SorianoJuan/chacaico-automation/firmware/nodes/node_2/README.md

# Nodo 2

Firmware **0.5.0**, ID LoRa **2**, placa objetivo **HTCC-AB01 / ASR6501**.
La revisión impresa de esta PCB debe verificarse por separado; no se infiere de la del nodo 1.

- `node_2.ino`: entrada Arduino; rechaza una configuración de otro ID.
- `profile.json`: identidad pública, perfil de compilación y versión.
- `node_config.h`: encabezado **privado e ignorado**, generado desde `.secrets/node-2.json`.
- `build/`: compilación de este nodo, **ignorada** porque el binario incorpora su clave.
- `evidence/`: resultado histórico público de la prueba USB/LoRa.

La lógica está en `../../libraries/ChacaicoNode/src/ChacaicoNode.h` y se comparte
con los otros nodos. Cada nodo mantiene su propia clave y compilación. GPIO2 abre,
GPIO1 cierra, ambos con pulso configurable (50 ms predeterminado); el LED de prueba
conserva su estado tras los destellos. Reposo y pulso se configuran desde la pestaña
Configuración LoRa y se conservan en flash. OTA de firmware no implementado.
Máximo configurable **3000 ms**, pulso aplicado **50 ms**. Requiere bridge0.4.3.
Usar pulsos largos solo con el CubeCell separado de la PCB y la válvula.

Ver [operación y límites](../../../docs/node-configuration.md).

Desde la raíz del repo:

```sh
python3 firmware/build-node.py --id 2
sh firmware/flash-node.sh --id 2 /dev/serial/by-path/PUERTO_FISICO-port0
```

Antes de cargar, identificar físicamente la placa y conectar su antena. Los
CP2102 comparten serial0001: el puerto USB no determina el ID LoRa. La carga USB
reinicia el nodo; no se ejecuta como parte de pruebas offline.

0.5.0 agrega potencia TX, ventanas configurables, señal de bajada y prueba/commit
de potencia. Migra flash anterior; no volver a firmware0.4.x después de migrar.
