SorianoJuan/chacaico-automation/docs/evidence/2026-10-20/both-pulse-limit/home-assistant-confirmed.png

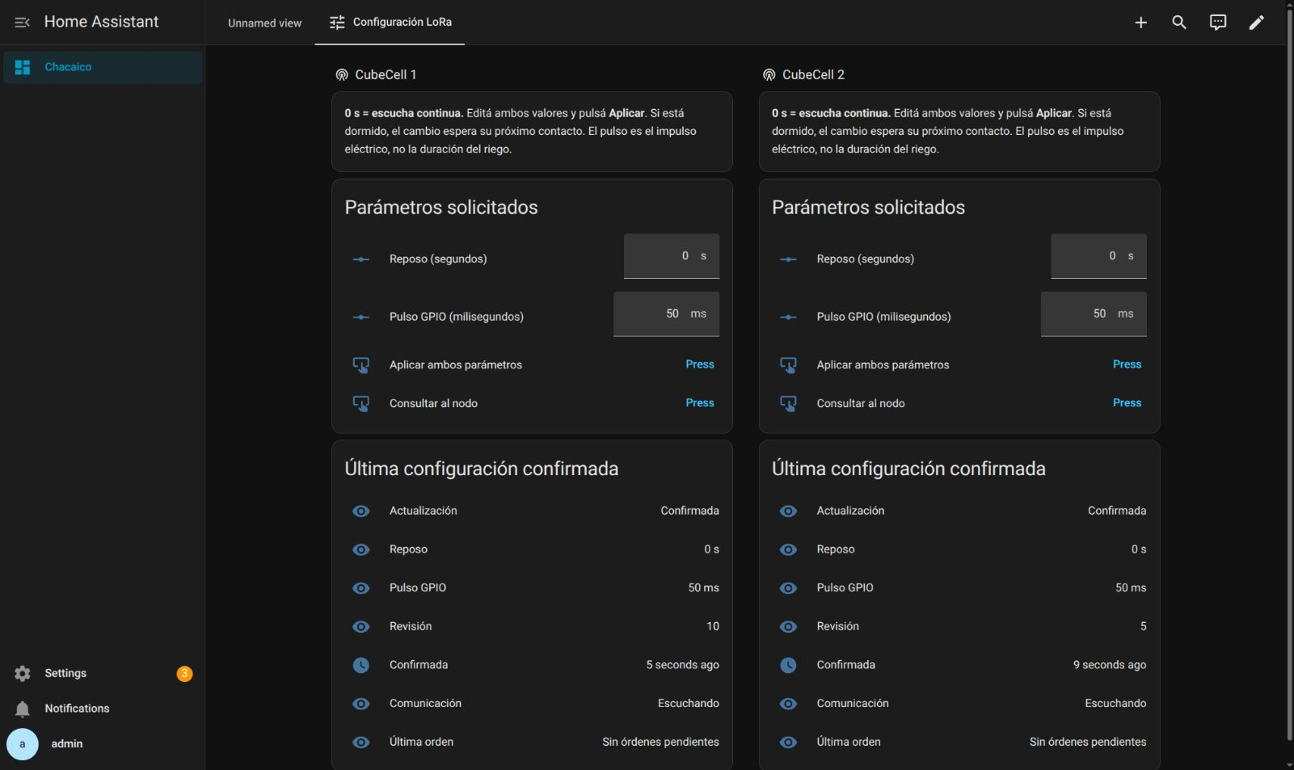
docs/evidence/2026-10-20/both-pulse-limit/home-assistant-confirmed.png
