SorianoJuan/chacaico-automation/docs/evidence/2026-10-22/radio-configuration-stage1/configuracion-lora.png

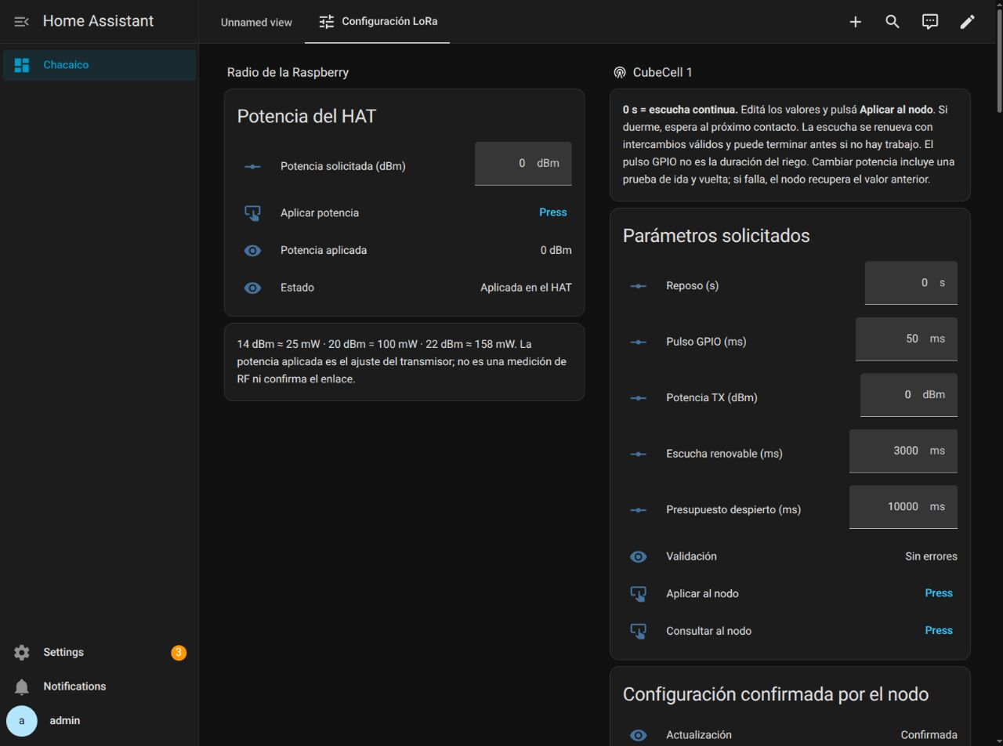
docs/evidence/2026-10-22/radio-configuration-stage1/configuracion-lora.png
