SorianoJuan/chacaico-automation/docs/hardware/adaptacion-aop605-9v.png

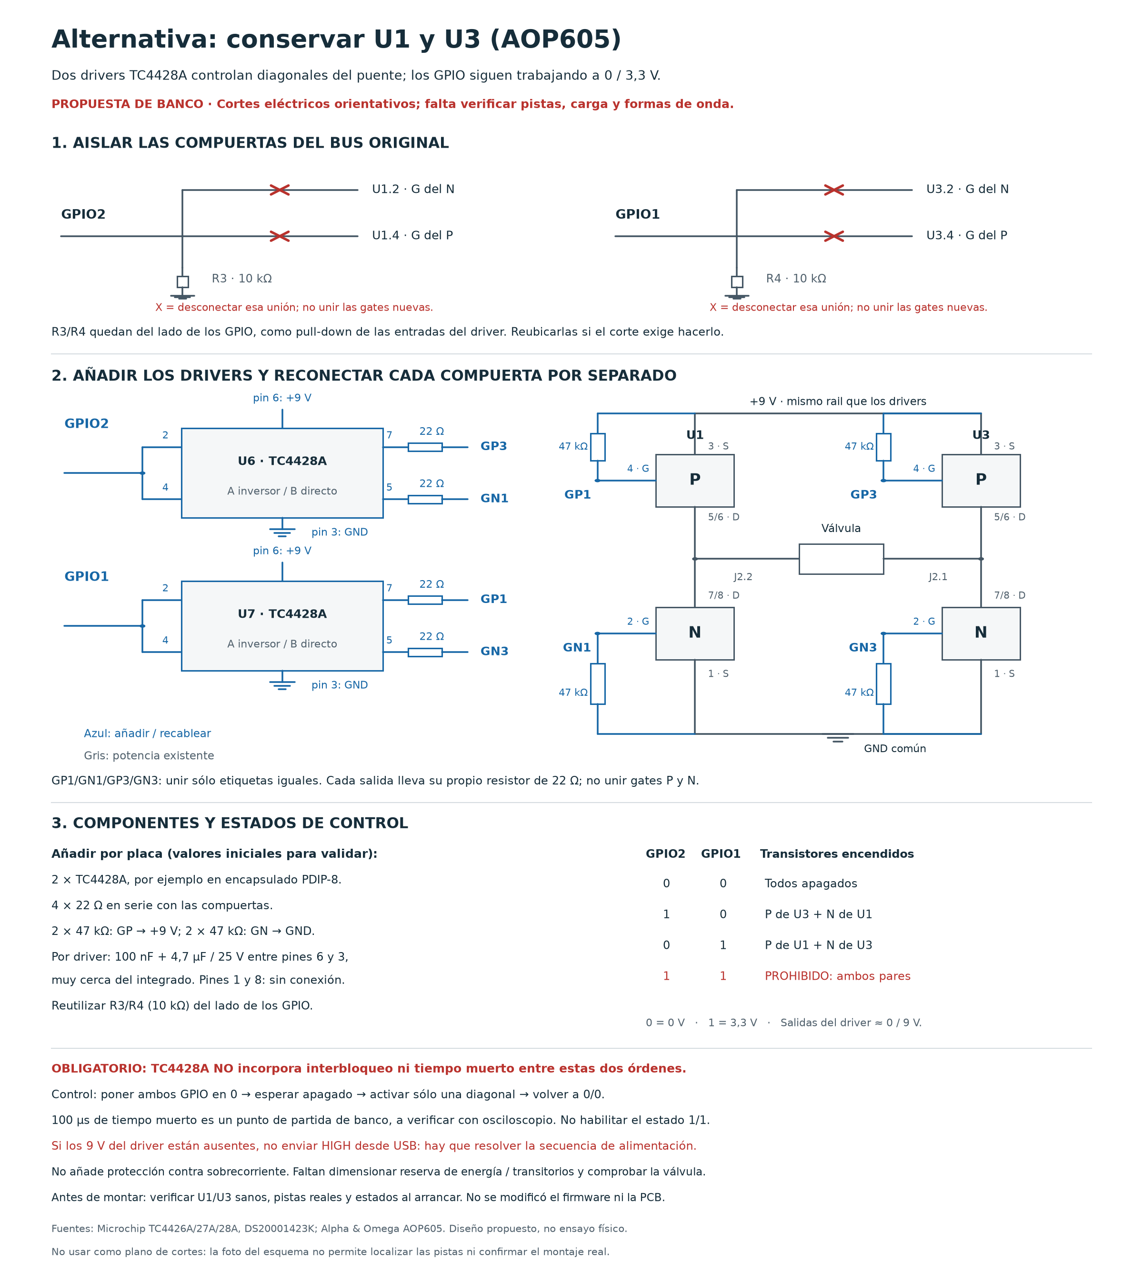
docs/hardware/adaptacion-aop605-9v.png
