SorianoJuan/chacaico-automation/docs/hardware/problema-mosfet-9v.png

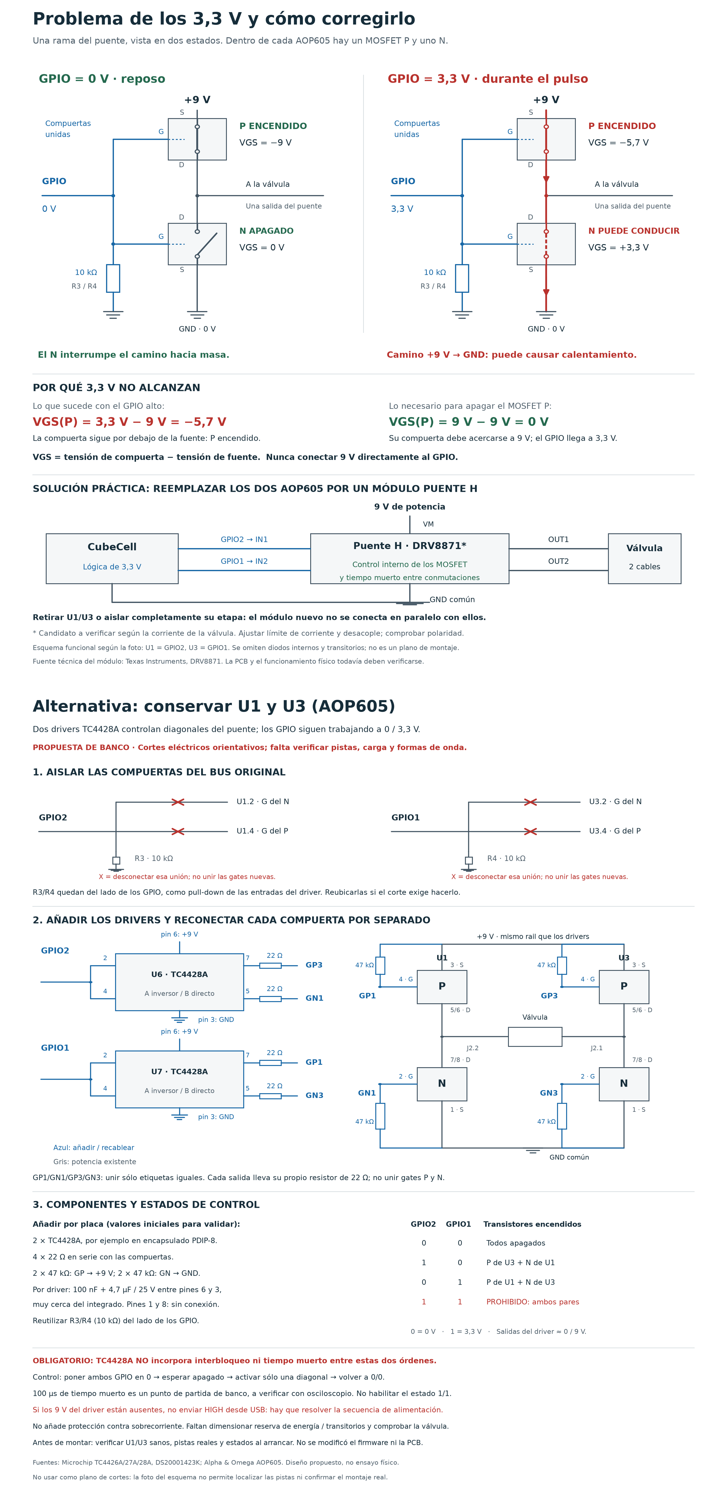
docs/hardware/problema-mosfet-9v.png
