SorianoJuan/chacaico-automation/home-assistant/evidence/configuracion-lora-minimalista.png

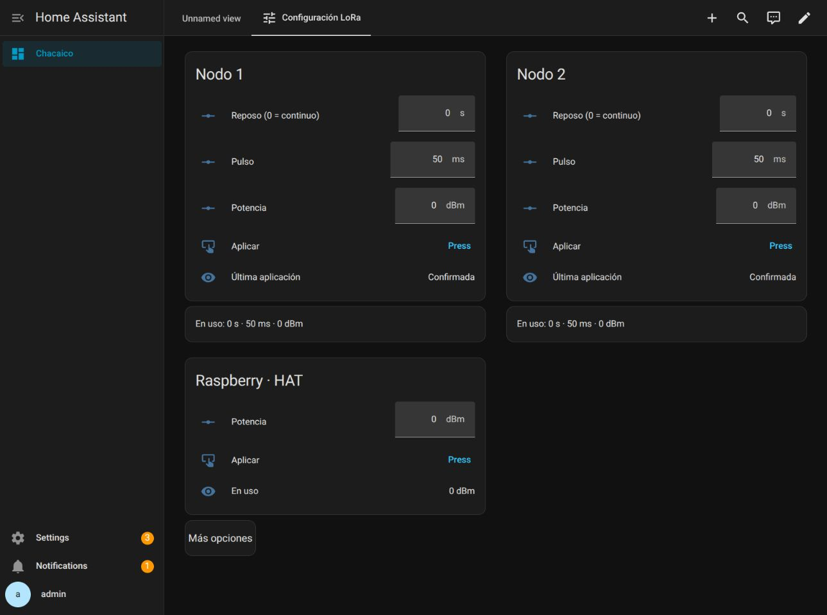
home-assistant/evidence/configuracion-lora-minimalista.png
