SorianoJuan/chacaico-automation/home-assistant/evidence/funnel-login.png

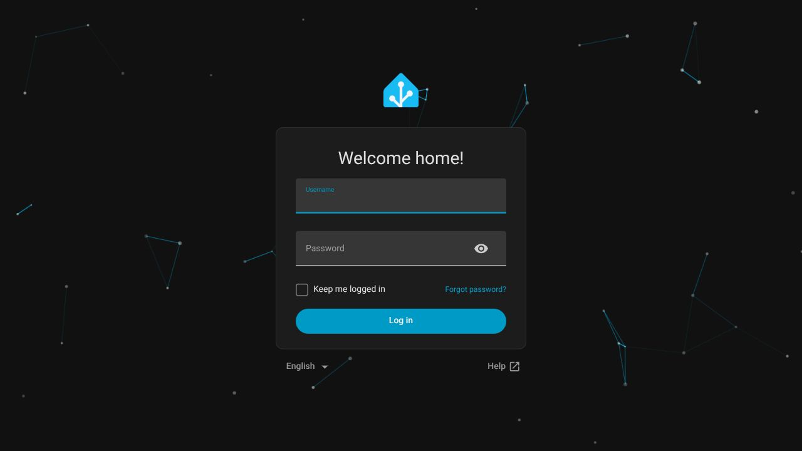
home-assistant/evidence/funnel-login.png
