SorianoJuan/chacaico-automation/home-assistant/evidence/sleep30-valve-confirmed.png

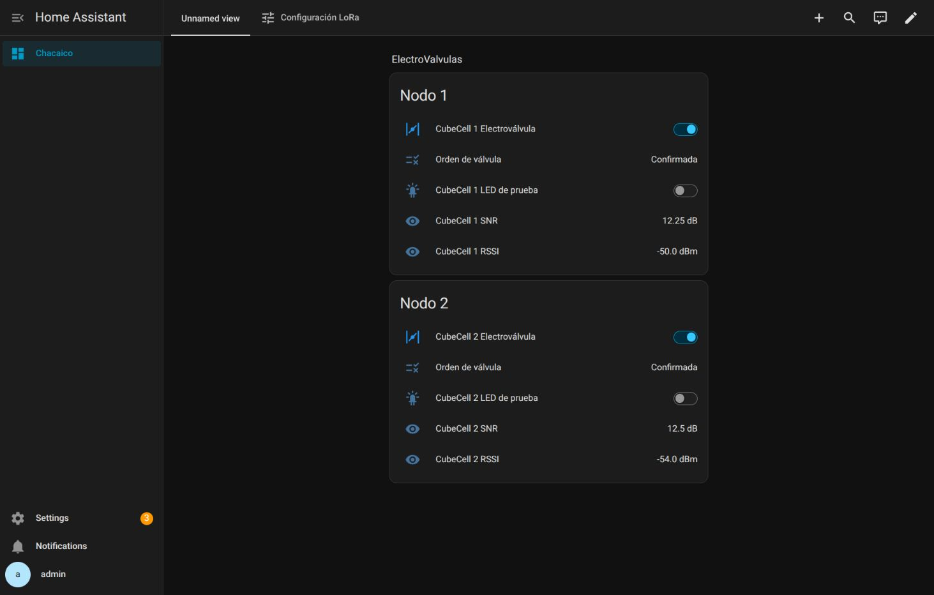
home-assistant/evidence/sleep30-valve-confirmed.png
