SorianoJuan/chacaico-automation/home-assistant/evidence/valve-order-status-view.png

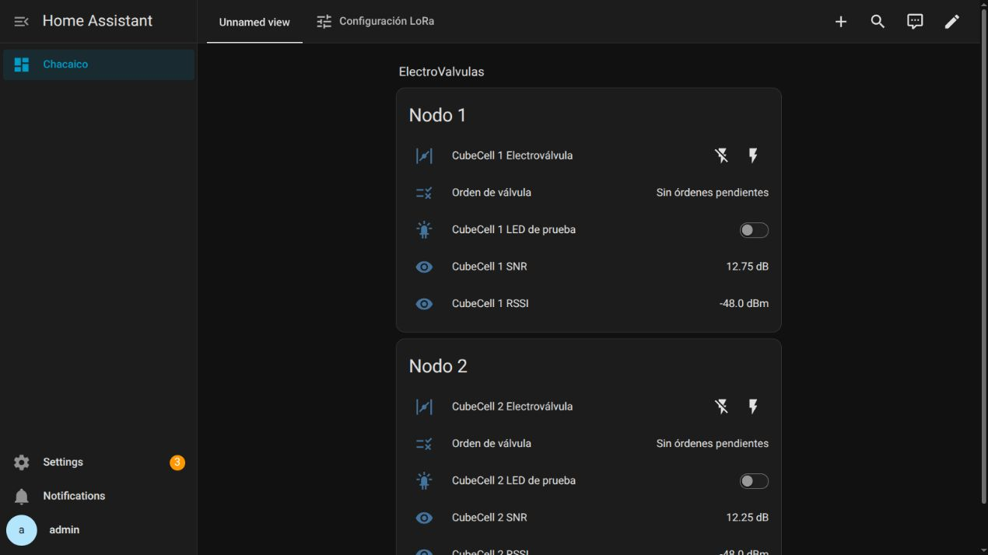
home-assistant/evidence/valve-order-status-view.png
