SorianoJuan/chacaico-automation/docs/evidence/2026-10-20/both-pulse-limit/unit-tests.txt

test_changed_private_header_is_rejected (test_build_identity.BuildIdentityTest.test_changed_private_header_is_rejected) ... ok
test_changed_shared_application_is_rejected (test_build_identity.BuildIdentityTest.test_changed_shared_application_is_rejected) ... ok
test_changed_upload_image_is_rejected (test_build_identity.BuildIdentityTest.test_changed_upload_image_is_rejected) ... ok
test_incomplete_source_checks_are_rejected (test_build_identity.BuildIdentityTest.test_incomplete_source_checks_are_rejected) ... ok
test_matching_identity_and_unchanged_files_pass (test_build_identity.BuildIdentityTest.test_matching_identity_and_unchanged_files_pass) ... ok
test_other_node_build_is_rejected (test_build_identity.BuildIdentityTest.test_other_node_build_is_rejected) ... ok
test_healthy_turnaround_is_before_ack (test_radio_turnaround.RadioTurnaroundTest.test_healthy_turnaround_is_before_ack) ... ok
test_scheduler_stall_can_miss_entire_ack (test_radio_turnaround.RadioTurnaroundTest.test_scheduler_stall_can_miss_entire_ack) ... ok
test_tx_timeout_still_restores_rx (test_radio_turnaround.RadioTurnaroundTest.test_tx_timeout_still_restores_rx) ... ok
test_all_frame_bits_are_authenticated (test_valve_bridge.EngineTest.test_all_frame_bits_are_authenticated) ... ok
test_apply_is_atomic_and_confirmed_only_after_matching_ack (test_valve_bridge.EngineTest.test_apply_is_atomic_and_confirmed_only_after_matching_ack) ... ok
test_apply_twice_does_not_allocate_second_revision (test_valve_bridge.EngineTest.test_apply_twice_does_not_allocate_second_revision) ... ok
test_boot_rollback_is_rejected_after_bridge_restart (test_valve_bridge.EngineTest.test_boot_rollback_is_rejected_after_bridge_restart) ... ok
test_both_node_pulse_limits_and_persistence (test_valve_bridge.EngineTest.test_both_node_pulse_limits_and_persistence) ... ok
test_config_storage_failure_is_visible_and_not_confirmed (test_valve_bridge.EngineTest.test_config_storage_failure_is_visible_and_not_confirmed) ... ok
test_conflict_refreshes_revision (test_valve_bridge.EngineTest.test_conflict_refreshes_revision) ... ok
test_duplicate_clicks_coalesce_and_close_cancels_unsent_open (test_valve_bridge.EngineTest.test_duplicate_clicks_coalesce_and_close_cancels_unsent_open) ... ok
test_editing_only_changes_draft (test_valve_bridge.EngineTest.test_editing_only_changes_draft) ... ok
test_expected_sleep_keeps_last_state_available (test_valve_bridge.EngineTest.test_expected_sleep_keeps_last_state_available) ... ok
test_expired_open_is_not_executed_at_late_wake (test_valve_bridge.EngineTest.test_expired_open_is_not_executed_at_late_wake) ... ok
test_expired_valve_status_survives_telemetry_and_led_command (test_valve_bridge.EngineTest.test_expired_valve_status_survives_telemetry_and_led_command) ... ok
test_initial_ready_requires_query_before_confirmed (test_valve_bridge.EngineTest.test_initial_ready_requires_query_before_confirmed) ... ok
test_invalid_fields_and_retained_commands_do_not_apply (test_valve_bridge.EngineTest.test_invalid_fields_and_retained_commands_do_not_apply) ... ok
test_long_pulse_ack_keeps_pending_and_radio_receive_window (test_valve_bridge.EngineTest.test_long_pulse_ack_keeps_pending_and_radio_receive_window) ... ok
test_long_pulse_ack_keeps_pending_and_radio_receive_window_node_two (test_valve_bridge.EngineTest.test_long_pulse_ack_keeps_pending_and_radio_receive_window_node_two) ... ok
test_long_pulse_waits_for_next_wake_if_budget_is_insufficient (test_valve_bridge.EngineTest.test_long_pulse_waits_for_next_wake_if_budget_is_insufficient) ... ok
test_long_pulse_waits_for_next_wake_if_budget_is_insufficient_node_two (test_valve_bridge.EngineTest.test_long_pulse_waits_for_next_wake_if_budget_is_insufficient_node_two) ... ok
test_lost_config_ack_recovers_via_query_without_new_revision (test_valve_bridge.EngineTest.test_lost_config_ack_recovers_via_query_without_new_revision) ... ok
test_lost_end_ack_does_not_send_retries_into_sleep (test_valve_bridge.EngineTest.test_lost_end_ack_does_not_send_retries_into_sleep) ... ok
test_lost_led_ack_triggers_readback (test_valve_bridge.EngineTest.test_lost_led_ack_triggers_readback) ... ok
test_lost_long_pulse_ack_retries_same_transaction (test_valve_bridge.EngineTest.test_lost_long_pulse_ack_retries_same_transaction) ... ok
test_lost_long_pulse_ack_retries_same_transaction_node_two (test_valve_bridge.EngineTest.test_lost_long_pulse_ack_retries_same_transaction_node_two) ... ok
test_new_apply_during_previous_transaction_preserves_new_intent (test_valve_bridge.EngineTest.test_new_apply_during_previous_transaction_preserves_new_intent) ... ok
test_new_close_supersedes_inflight_open_ack (test_valve_bridge.EngineTest.test_new_close_supersedes_inflight_open_ack) ... ok
test_old_session_cannot_confirm_or_reopen_window (test_valve_bridge.EngineTest.test_old_session_cannot_confirm_or_reopen_window) ... ok
test_other_node_progresses_during_missing_ack (test_valve_bridge.EngineTest.test_other_node_progresses_during_missing_ack) ... ok
test_outdated_config_job_expires_without_transmission (test_valve_bridge.EngineTest.test_outdated_config_job_expires_without_transmission) ... ok
test_pending_commands_are_not_replayed_after_bridge_restart (test_valve_bridge.EngineTest.test_pending_commands_are_not_replayed_after_bridge_restart) ... ok
test_pending_config_survives_bridge_restart (test_valve_bridge.EngineTest.test_pending_config_survives_bridge_restart) ... ok
test_reconnect_initializes_command_status (test_valve_bridge.EngineTest.test_reconnect_initializes_command_status) ... ok
test_restart_after_lost_ack_reads_effective_config (test_valve_bridge.EngineTest.test_restart_after_lost_ack_reads_effective_config) ... ok
test_restart_does_not_replay_or_claim_confirmed_valve_command (test_valve_bridge.EngineTest.test_restart_does_not_replay_or_claim_confirmed_valve_command) ... ok
test_same_configuration_is_a_noop (test_valve_bridge.EngineTest.test_same_configuration_is_a_noop) ... ok
test_sequence_reservation_survives_restart_without_reuse (test_valve_bridge.EngineTest.test_sequence_reservation_survives_restart_without_reuse) ... ok
test_sleep_transition_after_long_continuous_run_has_fresh_window (test_valve_bridge.EngineTest.test_sleep_transition_after_long_continuous_run_has_fresh_window) ... ok
test_storage_error_remains_visible_until_explicit_query (test_valve_bridge.EngineTest.test_storage_error_remains_visible_until_explicit_query) ... ok
test_valve_status_survives_led_ack_and_unrelated_reports (test_valve_bridge.EngineTest.test_valve_status_survives_led_ack_and_unrelated_reports) ... ok
test_window_end_reconciles_uncertain_actuation (test_valve_bridge.EngineTest.test_window_end_reconciles_uncertain_actuation) ... ok
test_wrong_node_key_sequence_and_operation_never_ack (test_valve_bridge.EngineTest.test_wrong_node_key_sequence_and_operation_never_ack) ... ok
test_zero_sleep_returns_to_continuous_receive (test_valve_bridge.EngineTest.test_zero_sleep_returns_to_continuous_receive) ... ok

----------------------------------------------------------------------
Ran 50 tests in 0.039s

OK
