SorianoJuan/chacaico-automation/docs/evidence/2026-10-23/horarios-diarios/README.md

# Rango diario Desde / Hasta — 23/10/2026

A pedido del usuario se reemplazó la grilla semanal por dos campos de hora
editables directamente para cada válvula. Todos los días, con cruce de medianoche;
horas iguales significan sin riego. Se conservan temporada, selector por válvula
y estado confirmado/pendiente. La vista mantiene dos columnas y el perfil admin
se configuró en24h para que las horas y las etiquetas se vean completas.

## Verificado

- 103 pruebas offline: rangos diurnos y nocturnos, inicio/final, horas iguales,
  input no disponible, día local con cambio horario, persistencia, confirmaciones,
  plazos y reintentos anteriores. Ejecutan el YAML y macro Jinja reales.
- `ha core check` y reinicio de Core correctos; ocho entidades input_datetime.
- Editar Desde08:00 / Hasta09:00 del nodo1 desde UI con temporada OFF, leer
  esos valores persistidos en restore_state y restaurar00:00–00:00.
- Todos los rangos finales00:00–00:00; temporada OFF. Las otras tres vistas
  quedaron idénticas a la copia previa.
- No hubo errores de plantilla/controlador en los logs revisados.
- Los cuatro cierres ya estaban pendientes antes de esta actualización. Se
  conservaron sus responsables e intenciones; no se validó accionando válvulas
  ni se cancelaron sus reintentos. Los nodos seguían sin contacto en la UI.

Bridge0.5.1 y firmware sin cambios. Los antiguos Schedule vacíos se conservaron
sin referencia en el controlador diario. Respaldo privado indicado en validation.json;
no contiene el dashboard ni estados privados completos en Git.

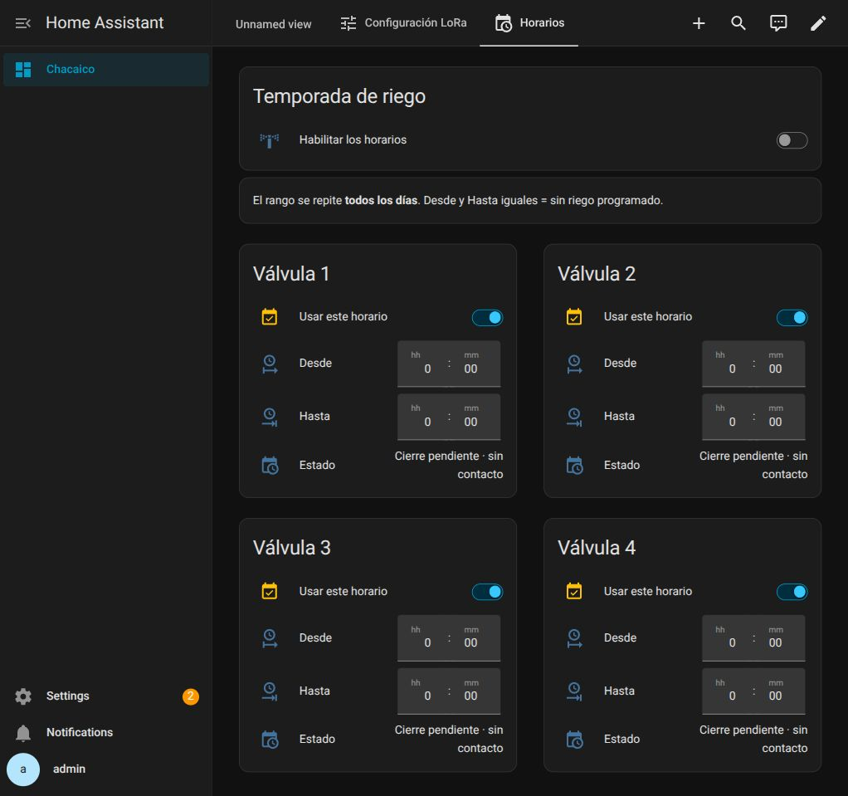
[picture p14: docs/evidence/2026-10-23/horarios-diarios/horarios-desde-hasta.png]
Campos diarios Desde y Hasta


Las etiquetas visibles se cambiaron a **Horario de inicio** y **Horario de corte**,
a pedido del usuario. Verificadas completas en las cuatro tarjetas; misma lógica,
entidades y valores.

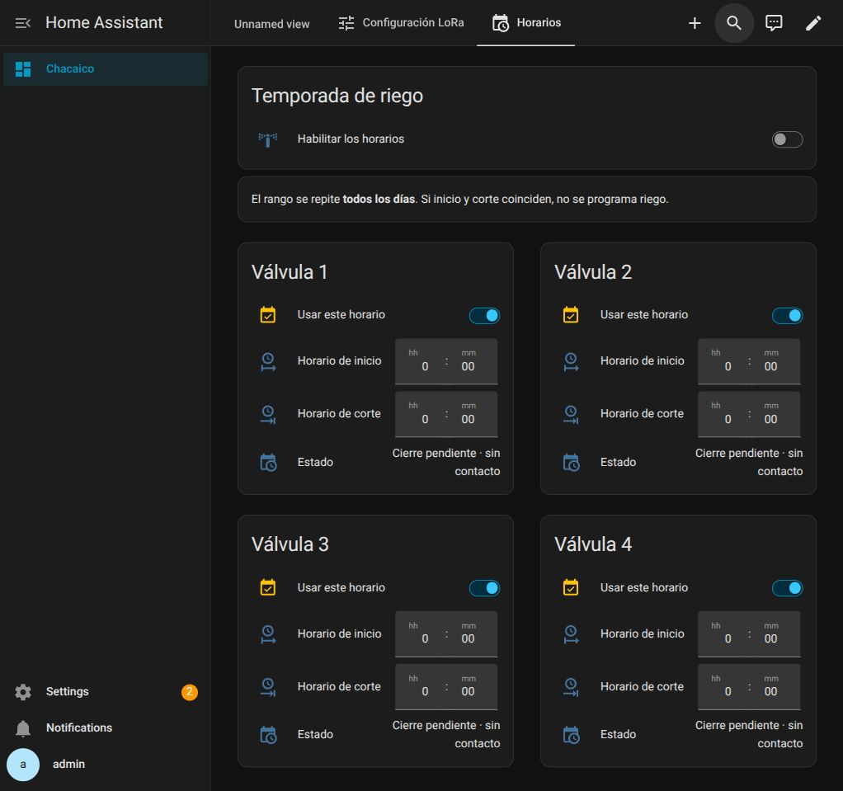
[picture p15: docs/evidence/2026-10-23/horarios-diarios/horarios-inicio-corte.png]
Etiquetas de inicio y corte


## Tarjetas visibles solo durante la temporada

Se retiró la tarjeta explicativa de horas iguales. Las cuatro secciones de
válvula tienen visibilidad nativa condicionada a temporada ON y su selector
se rotula **Habilitar riego por horarios**.

Verificado en HA: temporada OFF muestra solo la tarjeta de temporada; el editor
permite comprobar las cuatro etiquetas nuevas sin activar el riego. Prueba
existente de combinación de vistas aprobada (1 test); las otras tres vistas
se preservaron idénticas al respaldo previo. Cambio visual, sin reiniciar Core,
modificar horarios ni enviar acciones a las válvulas. Los cierres pendientes
siguen bajo el mismo controlador.

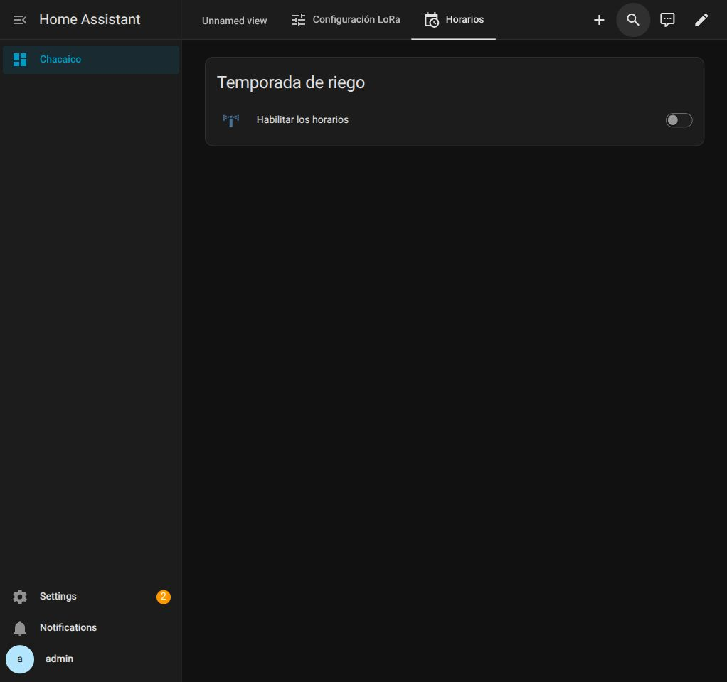
[picture p16: docs/evidence/2026-10-23/horarios-diarios/horarios-temporada-off.png]
Temporada apagada: tarjetas de válvula ocultas
