SorianoJuan/chacaico-automation/bridge/chacaico_lora_bridge/engine.py

"""Single-threaded radio scheduler. MQTT callbacks feed it through a queue."""
from dataclasses import dataclass, field, replace
import json
import logging
import math
import os
from pathlib import Path
from protocol import *

LOG = logging.getLogger("chacaico")
ROOT = "chacaico/lora"
ERRORS = {INVALID: "Parámetros inválidos", STORE_FAILED: "Error de memoria",
          CONFLICT: "Conflicto de revisión", BUSY: "Ventana terminando"}


def atomic_json(path, value):
    temporary = path.with_suffix(".tmp")
    with temporary.open("w") as stream:
        json.dump(value, stream)
        stream.flush()
        os.fsync(stream.fileno())
    os.replace(temporary, path)
    descriptor = os.open(path.parent, os.O_RDONLY | os.O_DIRECTORY)
    try:
        os.fsync(descriptor)
    finally:
        os.close(descriptor)


class Sequence:
    """Reserve blocks before use; no SD write for each wake/packet."""
    def __init__(self, path):
        self.path = path
        self.value = json.loads(path.read_text()) if path.exists() else 0
        if type(self.value) is not int or not 0 <= self.value <= 0xffffffff:
            raise ValueError("Invalid sequence store; restore its backup")
        self.limit = self.value

    def next(self):
        if self.value == self.limit:
            if self.value > 0xffffffff - 1024:
                raise ValueError("Sequence space exhausted")
            atomic_json(self.path, self.value + 1024)
            self.limit = self.value + 1024
        self.value += 1
        return self.value


@dataclass
class Node:
    ident: int
    boot: int = 0
    wake: int = 0
    seen: float = -math.inf
    active_until: float = 0
    hard_until: float = 0
    next_query: float = 0
    advertised: dict = field(default_factory=lambda: {"revision": 1, **CONFIG_DEFAULTS})
    confirmed: dict | None = None
    draft: dict | None = None
    config_job: dict | None = None
    config_status: str = "Sin confirmar"
    config_error: str | None = None
    command_status: str = "Sin órdenes pendientes"
    verified: bool = False
    need_query: bool = True
    reconcile: bool = False
    closed: bool = False
    radio_fault: bool = False
    pending: dict | None = None
    actions: dict = field(default_factory=dict)
    action_status: dict = field(default_factory=dict)
    backoff: float = 0
    last_tx: float = -math.inf
    protocol_version: int = 0  # Unknown until an authenticated READY in this session.
    trial_config: dict | None = None
    policy: dict = field(default_factory=lambda: dict(POLICY_DEFAULTS))
    policy_draft: dict = field(default_factory=lambda: dict(POLICY_DEFAULTS))
    metrics: dict = field(default_factory=lambda: {
        "orders": 0, "confirmed": 0, "expired": 0, "superseded": 0,
        "tx_attempts": 0, "tx_errors": 0, "retries": 0, "acks": 0,
        "last_attempts": None, "last_queue_s": None, "last_delivery_s": None,
        "last_total_s": None, "last_ack_ms": None, "uplink_rssi": None,
        "uplink_snr": None, "downlink_rssi": None, "downlink_snr": None})


class Engine:
    def __init__(self, keys, directory, publish, monotonic, wall, set_power=None):
        self.keys, self.publish, self.now, self.wall = keys, publish, monotonic, wall
        directory = Path(directory)
        directory.mkdir(parents=True, exist_ok=True)
        self.file = directory / "runtime-v2.json"
        self.sequence = Sequence(directory / "sequence.json")
        saved = json.loads(self.file.read_text()) if self.file.exists() else {"version": 1, "nodes": {}}
        if saved.get("version") not in (1, 2) or not isinstance(saved.get("nodes"), dict):
            raise ValueError("Invalid runtime store")
        self.nodes = {ident: Node(ident) for ident in keys}
        self.published = {}
        self.tx_ready = 0
        self.metrics_started_at = self.wall()
        self.set_power = set_power
        self.bridge_power = saved.get("bridge_power", 0)
        self.bridge_power_draft = saved.get("bridge_power_draft", self.bridge_power)
        for value in (self.bridge_power, self.bridge_power_draft):
            if type(value) is not int or not 0 <= value <= 22:
                raise ValueError("Invalid saved bridge power")
        if self.set_power:
            self.set_power(self.bridge_power)
        self.bridge_power_status = "Aplicada en el HAT"
        for ident, n in self.nodes.items():
            old = saved["nodes"].get(str(ident), {})
            n.confirmed, n.draft, n.config_job = (old.get(k) for k in ("confirmed", "draft", "config_job"))
            for key in ("confirmed", "draft", "config_job"):
                value = getattr(n, key)
                if value:
                    setattr(n, key, {**CONFIG_DEFAULTS, **value})
            n.policy = old.get("policy", dict(POLICY_DEFAULTS))
            n.policy_draft = old.get("policy_draft", dict(n.policy))
            if not valid_policy(n.policy) or not valid_policy(n.policy_draft):
                raise ValueError("Invalid saved node policy")
            n.boot = old.get("boot", 0)
            n.config_error = old.get("config_error")
            if n.config_error:
                n.config_status = n.config_error
            for cfg in (n.confirmed, n.draft):
                if cfg and not valid_config(**{k: cfg.get(k) for k in CONFIG_KEYS}, node=ident):
                    raise ValueError("Invalid stored configuration")
            if n.confirmed:
                n.advertised = dict(n.confirmed)
            if n.config_job:
                if (not valid_config(**{k: n.config_job.get(k) for k in CONFIG_KEYS}, node=ident)
                        or not isinstance(n.config_job.get("deadline"), (int, float))
                        or not math.isfinite(n.config_job["deadline"])
                        or (n.config_job.get("revision") is not None and
                            (type(n.config_job["revision"]) is not int or not 1 <= n.config_job["revision"] <= 0xffffffff))):
                    raise ValueError("Invalid pending configuration")
                n.config_status = "Pendiente de contacto"

    def persist(self):
        atomic_json(self.file, {"version": 2, "bridge_power": self.bridge_power,
            "bridge_power_draft": self.bridge_power_draft, "nodes": {str(i): {
            "confirmed": n.confirmed, "draft": n.draft, "config_job": n.config_job,
            "boot": n.boot, "config_error": n.config_error,
            "policy": n.policy, "policy_draft": n.policy_draft} for i, n in self.nodes.items()}})

    def emit(self, node, suffix, value, force=False):
        if suffix == "command/status":
            self.nodes[node].command_status = value
        topic = f"{ROOT}/node/{node}/{suffix}"
        serialized = json.dumps(value, sort_keys=True) if not isinstance(value, str) else value
        if force or self.published.get(topic) != serialized:
            self.publish(topic, value)
            self.published[topic] = serialized

    def action_view(self, n, op, status):
        # Last actuator command is independent from telemetry and the other actuator.
        n.action_status[op] = status
        resource = "valve" if op == SET_VALVE else "led"
        self.emit(n.ident, resource + "/command/status", status)
        self.emit(n.ident, "command/status", status)

    def config_view(self, n):
        draft = n.draft or n.confirmed or CONFIG_DEFAULTS
        self.emit(n.ident, "config/draft", {k: draft[k] for k in CONFIG_KEYS})
        self.emit(n.ident, "config/status", n.config_status)
        self.emit(n.ident, "config/protocol", {0: "Pendiente de contacto", 2: "v2 / actualizar firmware", 3: "v3"}[n.protocol_version])
        self.emit(n.ident, "policy/draft", n.policy_draft)
        self.emit(n.ident, "policy/reported", n.policy)
        self.emit(n.ident, "policy/status", "Aplicada en el puente" if n.policy == n.policy_draft else "Borrador sin aplicar")
        if n.confirmed:
            self.emit(n.ident, "config/reported", n.confirmed)

    def reconnect(self):
        self.published.clear()
        self.bridge_view()
        for n in self.nodes.values():
            n.need_query = True
            self.config_view(n)
            self.emit(n.ident, "config/input_error", "Sin errores")
            for op, resource in ((SET_VALVE, "valve"), (SET_LED, "led")):
                self.emit(n.ident, resource + "/command/status",
                          n.action_status.get(op, "Sin órdenes pendientes"))
            self.emit(n.ident, "command/status", n.command_status)
        self.tick()

    def message(self, node, resource, payload, retained=False):
        if retained or node not in self.nodes:
            return
        n = self.nodes[node]
        if resource.startswith("policy/"):
            if resource == "policy/apply" and payload == "APPLY":
                n.policy = dict(n.policy_draft)
                self.persist(); self.config_view(n); return
            if resource.endswith("/set"):
                key = resource.split("/")[1]
                if key not in POLICY_DEFAULTS:
                    return
                try:
                    value = float(payload)
                    if not math.isfinite(value) or not value.is_integer():
                        return
                    draft = {**n.policy_draft, key: int(value)}
                    if not valid_policy(draft):
                        return
                except (ValueError, OverflowError):
                    return
                n.policy_draft = draft
                self.persist(); self.config_view(n)
            return
        if resource.startswith("config/") and resource.endswith("/set"):
            name = resource.split("/")[1]
            if name not in CONFIG_KEYS:
                return
            try:
                value = float(payload)
                if not math.isfinite(value) or not value.is_integer():
                    return
                draft = {k: (n.draft or n.confirmed or n.advertised)[k] for k in CONFIG_KEYS}
                draft[name] = int(value)
                if not valid_config(**draft, node=node):
                    self.emit(node, "config/input_error", "Combinación inválida: máximo despierto ≥ escucha + 1000 ms y pulso + 2000 ms")
                    self.config_view(n)
                    return
            except (ValueError, OverflowError):
                return
            n.draft = draft
            self.emit(node, "config/input_error", "Sin errores")
            self.persist()
            self.config_view(n)
            return
        if resource == "config/apply" and payload == "APPLY":
            if n.protocol_version == 2 and any((n.draft or n.advertised)[k] != CONFIG_DEFAULTS[k]
                    for k in ("tx_power_dbm", "listen_ms", "max_awake_ms")):
                n.config_error = n.config_status = "Requiere firmware 0.5.0"
                self.persist(); self.config_view(n); return
            n.config_error = None
            cfg = dict(n.draft or n.confirmed or n.advertised)
            cfg = {k: cfg[k] for k in CONFIG_KEYS}
            if n.verified and n.confirmed and all(n.confirmed[k] == cfg[k] for k in cfg) and not n.config_job:
                n.config_status = "Confirmada"
            elif n.config_job and all(n.config_job[k] == cfg[k] for k in cfg):
                return  # A repeated click is the same durable transaction.
            else:
                n.config_job = {**cfg, "revision": None, "deadline": self.wall() + 86400}
                n.config_status = "Pendiente de contacto"
                n.need_query = True
            self.persist()
            self.config_view(n)
            return
        if resource == "config/query" and payload == "QUERY":
            n.config_error = None
            self.persist()
            n.need_query = True
            n.config_status = "Consultando" if not n.config_job else "Pendiente de contacto"
            self.config_view(n)
            return
        # Scheduled OPEN commands carry an absolute boundary. Manual commands remain
        # the original strings. Do not let a queued opening outlive its time slot.
        valid_until = None
        if resource == "valve/set" and payload.startswith("{"):
            try:
                command = json.loads(payload)
                valid_until = command["valid_until"]
                if (command["state"] != "OPEN" or type(valid_until) not in (int, float)
                        or not math.isfinite(valid_until) or valid_until <= self.wall()):
                    return
            except (ValueError, KeyError, TypeError):
                return
            payload = "OPEN"
        choices = {"led/set": (SET_LED, {"ON": 1, "OFF": 0}), "valve/set": (SET_VALVE, {"OPEN": 1, "CLOSE": 0})}
        if resource not in choices or payload not in choices[resource][1]:
            return
        op, values = choices[resource]
        value = values[payload]
        prior = n.actions.get(op)
        if prior and prior["value"] == value:
            if valid_until is not None:
                # Edits may shorten a pending slot, never extend an existing retry.
                prior["valid_until"] = min(prior.get("valid_until", valid_until), valid_until)
                prior["deadline"] = min(prior["deadline"], self.now() + valid_until - self.wall())
            return
        sleep = max(n.advertised["sleep_s"], (n.config_job or {}).get("sleep_s", 0))
        # Latest intent replaces an unsent opposite command, including a queued OPEN.
        if prior:
            n.metrics["superseded"] += 1
        n.metrics["orders"] += 1
        n.actions[op] = {"value": value, "deadline": self.now() + self.command_ttl(n, sleep),
                         "queued_at": self.now(), "first_sent_at": None, "attempts": 0}
        if valid_until is not None:
            n.actions[op]["valid_until"] = valid_until
            n.actions[op]["deadline"] = min(n.actions[op]["deadline"], self.now() + valid_until - self.wall())
        if n.pending and n.pending["frame"].op == op:
            n.pending = None  # Old ACK is no longer evidence for the current intent.
        self.emit(node, "valve/status" if op == SET_VALVE else "led/status",
                  {"confirmation": "pending", "command": payload, "state_source": "gpio_pulse" if op == SET_VALVE else "led"})
        self.action_view(n, op, "Pendiente")

    def bridge_view(self):
        self.publish(ROOT + "/bridge/power", {"requested": self.bridge_power_draft,
                     "applied": self.bridge_power, "status": self.bridge_power_status})

    def bridge_message(self, resource, payload, retained=False):
        if retained:
            return
        if resource == "power/set":
            try:
                value = float(payload)
                if not math.isfinite(value) or not value.is_integer() or not 0 <= value <= 22:
                    return
            except (ValueError, OverflowError):
                return
            self.bridge_power_draft = int(value)
            self.bridge_power_status = "Borrador sin aplicar" if value != self.bridge_power else "Aplicada en el HAT"
            self.persist()
        elif resource == "power/apply" and payload == "APPLY":
            if self.set_power is None:
                self.bridge_power_status = "Hardware no disponible"
            else:
                previous = self.bridge_power
                try:
                    self.set_power(self.bridge_power_draft)
                    self.bridge_power = self.bridge_power_draft
                    self.persist()
                except Exception:
                    self.bridge_power = previous
                    self.set_power(previous)
                    self.bridge_power_status = "Error; potencia anterior restaurada"
                    LOG.exception("Could not apply/persist bridge power")
                else:
                    self.bridge_power_status = "Aplicada en el HAT"
        else:
            return
        self.bridge_view()

    @staticmethod
    def command_ttl(n, sleep=None):
        sleep = max(n.advertised["sleep_s"], (n.config_job or {}).get("sleep_s", 0)) if sleep is None else sleep
        awake = max(n.advertised["max_awake_ms"], (n.config_job or {}).get("max_awake_ms", 0))
        return n.policy["command_ttl_s"] or max(15, sleep + awake / 1000 + 10)

    @staticmethod
    def contact_timeout(n):
        cfg = n.advertised
        period = cfg["sleep_s"] + cfg["max_awake_ms"] / 1000 + .25 if cfg["sleep_s"] else 32
        return n.policy["missed_contacts"] * period + 10

    def metrics_view(self, n):
        settled = n.metrics["confirmed"] + n.metrics["expired"]
        self.emit(n.ident, "metrics", {**n.metrics,
            "success_percent": round(100 * n.metrics["confirmed"] / settled, 1) if settled else None,
            "pending": len(n.actions), "started_at": self.metrics_started_at,
            "command_ttl_s": self.command_ttl(n), "contact_timeout_s": self.contact_timeout(n)})

    def finish_action(self, n, op, outcome):
        job = n.actions.pop(op)
        n.metrics[outcome] += 1
        n.metrics["last_attempts"] = job.get("attempts", 0)
        queued = job.get("queued_at", self.now())
        first = job.get("first_sent_at")
        n.metrics["last_queue_s"] = round((first if first is not None else self.now()) - queued, 3)
        n.metrics["last_delivery_s"] = round(self.now() - first, 3) if first is not None else None
        n.metrics["last_total_s"] = round(self.now() - queued, 3)

    def receive(self, packet, rssi, snr):
        try:
            ident = node_id(packet)
            f = decode(self.keys[ident], packet)
        except (ValueError, KeyError):
            return
        n = self.nodes[ident]
        now = self.now()
        if f.kind == READY:
            if f.boot < n.boot or (f.boot == n.boot and f.wake < n.wake):
                return
            if not f.boot or not f.wake:
                self.emit(ident, "config/status", "Error de memoria")
                return
            n.protocol_version = f.version
            new = (f.boot, f.wake) != (n.boot, n.wake)
            if new:
                new_boot = f.boot != n.boot
                n.boot, n.wake = f.boot, f.wake
                if n.pending and n.pending["frame"].op in (SET_LED, SET_VALVE, SET_CONFIG, COMMIT_CONFIG):
                    n.reconcile = True
                n.pending = None
                n.trial_config = None
                n.closed = False
                n.need_query = n.need_query or new_boot or not n.verified
                n.active_until = now + f.listen_ms / 1000 - .2
                n.hard_until = now + f.max_awake_ms / 1000 - .5
                n.backoff = now + .15
                if new_boot:
                    n.verified = False
                    self.emit(ident, "valve/state", "None")
                    self.persist()
            elif n.closed:
                return  # An old repeated READY never reopens a completed window.
            n.advertised = self.configuration(f)
            if n.config_job and f.version == 2 and any(n.config_job[k] != CONFIG_DEFAULTS[k]
                    for k in ("tx_power_dbm", "listen_ms", "max_awake_ms")):
                n.config_status = "Requiere firmware 0.5.0"
            n.radio_fault = f.status != OK
            if n.radio_fault:
                n.config_status = ERRORS.get(f.status, "Error del nodo")
                self.config_view(n)
                return
            if not f.sleep_s:
                n.active_until = math.inf
            # READY is a hint, not confirmation of the requested configuration.
            return
        p = n.pending
        if f.kind != RESPONSE or not p:
            return
        expected = p["frame"]
        if (f.boot, f.wake, f.sequence, f.op, f.version) != (expected.boot, expected.wake, expected.sequence, expected.op, expected.version):
            return
        # MQTT/run polls RX before tick: an ACK received after the order deadline
        # must not turn an already expired intent into a confirmed command.
        if (any(now >= job["deadline"] or self.wall() >= job.get("valid_until", math.inf) for job in n.actions.values())
                or (n.config_job and self.wall() > n.config_job["deadline"])):
            self.tick()
            if n.pending is not p:
                return
        if f.status == OK:
            if f.op == SET_LED and f.led != expected.led:
                return
            if f.op == SET_VALVE and f.valve != expected.valve:
                return
            if f.op in (SET_CONFIG, COMMIT_CONFIG) and self.configuration(f) != {
                    "revision": expected.revision, **{k: getattr(expected, k) for k in CONFIG_KEYS}}:
                return
        n.pending = None
        n.metrics["acks"] += 1
        n.metrics["last_ack_ms"] = round(1000 * (now - p["sent_at"]), 1) if "sent_at" in p else None
        n.metrics["uplink_rssi"], n.metrics["uplink_snr"] = rssi, snr
        n.metrics["downlink_rssi"] = None if f.downlink_rssi == 32767 else f.downlink_rssi
        n.metrics["downlink_snr"] = None if f.downlink_snr == 127 else f.downlink_snr
        n.seen = now
        if f.status == TRIAL:
            cfg = self.configuration(f)
            job = n.config_job
            if job and job.get("revision") == cfg["revision"] and all(job[k] == cfg[k] for k in CONFIG_KEYS):
                n.trial_config = cfg
                n.config_status = "Probando potencia; pendiente de guardar"
            else:
                n.trial_config = None
                n.need_query = True
            n.backoff = now + .2
            n.active_until = math.inf if not n.advertised["sleep_s"] and not cfg["sleep_s"] else now + 7
            n.hard_until = max(n.hard_until, now + 7)
            self.config_view(n); self.metrics_view(n); return
        n.trial_config = None
        n.backoff = now + .15
        if f.sleep_s and not n.advertised["sleep_s"]:
            n.hard_until = now + f.max_awake_ms / 1000 - 1
        if f.sleep_s:
            n.active_until = min(now + f.listen_ms / 1000 - .2, n.hard_until)
        else:
            n.active_until = math.inf
            n.closed = False
        self.report(n, f, rssi, snr)
        if f.status != OK:
            if f.status == BUSY:
                n.closed = True
                return
            if f.op in (SET_CONFIG, COMMIT_CONFIG) and n.config_job:
                if f.status == CONFLICT:
                    n.config_job["revision"] = None
                    n.need_query = True
                else:
                    n.config_job = None
                    n.config_error = n.config_status = ERRORS[f.status]
                self.persist()
                self.config_view(n)
            return
        if f.op in (GET_STATE, GET_CONFIG):
            n.need_query = False
            n.reconcile = False
            n.next_query = now + 30
        if f.op in (SET_LED, SET_VALVE):
            job = n.actions.get(f.op)
            actual = f.led if f.op == SET_LED else f.valve
            if job and job["value"] == actual:
                self.finish_action(n, f.op, "confirmed")
                self.action_view(n, f.op, "Confirmada")
        if f.op == END and f.sleep_s:
            n.closed = True
        LOG.info("ACK node=%d boot=%d wake=%d seq=%d op=%d result=%d revision=%d sleep=%d pulse=%d",
                 ident, f.boot, f.wake, f.sequence, f.op, f.status, f.revision, f.sleep_s, f.pulse_ms)

    @staticmethod
    def configuration(f):
        return {"revision": f.revision, **{k: getattr(f, k) for k in CONFIG_KEYS}}

    def report(self, n, f, rssi, snr):
        cfg = self.configuration(f)
        changed = not n.confirmed or any(n.confirmed.get(k) != v for k, v in cfg.items())
        n.advertised = cfg
        n.confirmed = {**cfg, "confirmed_at": self.wall()}
        n.verified = True
        if n.draft is None:
            n.draft = {k: cfg[k] for k in CONFIG_KEYS}
            changed = True
        job = n.config_job
        if job and all(cfg[k] == job[k] for k in CONFIG_KEYS):
            # Includes recovery after a lost SET_CONFIG ACK or bridge restart.
            if job["revision"] is None or cfg["revision"] >= job["revision"]:
                n.config_job = None
                changed = True
        unsupported = n.config_job and n.protocol_version == 2 and any(
            n.config_job[k] != CONFIG_DEFAULTS[k] for k in ("tx_power_dbm", "listen_ms", "max_awake_ms"))
        n.config_status = n.config_error or ("Requiere firmware 0.5.0" if unsupported else
                                             "Confirmada" if not n.config_job else "Pendiente")
        if changed:
            self.persist()
        for op, actual in ((SET_LED, f.led), (SET_VALVE, f.valve)):
            job = n.actions.get(op)
            if job and job["value"] == actual:
                self.finish_action(n, op, "confirmed")
                self.action_view(n, op, "Confirmada")
        self.config_view(n)
        self.emit(n.ident, "led/state", "ON" if f.led else "OFF")
        self.emit(n.ident, "valve/state", {0: "closed", 1: "open", UNKNOWN: "None"}[f.valve])
        self.emit(n.ident, "valve/status", {"sequence": f.sequence, "confirmation": "unknown" if f.valve == UNKNOWN else "confirmed",
                  "state_source": "gpio_pulse", "confirmed_at": self.wall(), "rssi": rssi, "snr": snr})
        self.emit(n.ident, "status", {"node": n.ident, "sequence": f.sequence, "boot": f.boot, "wake": f.wake,
                  "rssi": rssi, "snr": snr, "confirmed_at": self.wall(), "led": bool(f.led),
                  "valve": {0: "closed", 1: "open", UNKNOWN: "unknown"}[f.valve], "protocol": f.version})

    def tick(self):
        now = self.now()
        for n in self.nodes.values():
            alive = now - n.seen < self.contact_timeout(n)
            self.emit(n.ident, "availability", "online" if alive else "offline")
            self.emit(n.ident, "valve/availability", "online" if alive and n.verified else "offline")
            state = "Sin contacto" if not alive else (
                "Reposo esperado" if n.advertised["sleep_s"] and (n.closed or now >= n.active_until)
                else "Escuchando")
            self.emit(n.ident, "link/state", state)
            for op, job in list(n.actions.items()):
                if now >= job["deadline"] or self.wall() >= job.get("valid_until", math.inf):
                    self.finish_action(n, op, "expired")
                    if n.pending and n.pending["frame"].op == op:
                        n.pending = None
                    self.action_view(n, op, "Vencida sin confirmar")
                    self.emit(n.ident, "valve/status" if op == SET_VALVE else "led/status",
                              {"confirmation": "unconfirmed", "expired": True})
                    n.need_query = True
            if n.config_job and self.wall() > n.config_job["deadline"]:
                n.config_job = None
                n.trial_config = None
                if n.pending and n.pending["frame"].op in (SET_CONFIG, COMMIT_CONFIG):
                    n.pending = None
                n.config_error = n.config_status = "Vencida sin confirmar"
                self.persist()
                self.config_view(n)
            p = n.pending
            if p and now >= p["next"] and p["tries"] >= 3:
                n.pending = None
                n.trial_config = None
                if p["frame"].op == END:
                    n.closed = bool(n.advertised["sleep_s"])
                else:
                    n.need_query = True
                    n.reconcile = True
                    n.backoff = now + 1
                    if p["frame"].op in (SET_VALVE, SET_LED):
                        self.action_view(n, p["frame"].op, "Sin confirmación; consultando")
                    else:
                        self.emit(n.ident, "command/status", "Sin confirmación; consultando")
                    if p["frame"].op in (SET_CONFIG, COMMIT_CONFIG):
                        n.config_status = "Sin confirmación; consultando"
                        self.config_view(n)
            self.metrics_view(n)
            if n.pending and now >= n.active_until:
                if n.pending["frame"].op in (SET_LED, SET_VALVE, SET_CONFIG, COMMIT_CONFIG):
                    n.reconcile = True
                n.pending = None
                n.need_query = True

    def start(self, n, op, **values):
        f = Frame(REQUEST, n.ident, n.boot, n.wake, self.sequence.next(), op, version=n.protocol_version, **values)
        n.pending = {"frame": f, "packet": encode(self.keys[n.ident], f), "tries": 0, "next": 0}

    def next_frame(self):
        self.tick()
        now = self.now()
        if now < self.tx_ready:
            return None
        candidates = [n for n in self.nodes.values() if n.boot and n.wake and not n.closed and not n.radio_fault
                      and now < n.active_until and now >= n.backoff]
        # Round-robin by last transmission; offline nodes never occupy another window.
        for n in sorted(candidates, key=lambda item: (item.active_until, item.last_tx)):
            if n.pending:
                if now < n.pending["next"]:
                    continue
            else:
                required = 1.2 + (n.advertised["pulse_ms"] / 1000 if SET_VALVE in n.actions else 0)
                if n.trial_config:
                    cfg = n.trial_config
                    if n.config_job and all(n.config_job[k] == cfg[k] for k in CONFIG_KEYS):
                        self.start(n, COMMIT_CONFIG, **cfg)
                    else:
                        n.trial_config = None
                        self.start(n, GET_CONFIG)
                elif n.advertised["sleep_s"] and n.hard_until - now < required:
                    self.start(n, END)
                elif SET_VALVE in n.actions and n.actions[SET_VALVE]["value"] == 0:
                    self.start(n, SET_VALVE, valve=0)
                elif n.reconcile:
                    self.start(n, GET_CONFIG)
                elif n.actions:
                    # A session-bound actuator ACK also reports the full state/config.
                    # Deliver the user's intent before background queries can consume
                    # a short window. Lost-ACK retries remain the same transaction.
                    op = SET_VALVE if SET_VALVE in n.actions else SET_LED
                    self.start(n, op, **{"valve" if op == SET_VALVE else "led": n.actions[op]["value"]})
                elif n.need_query or (not n.advertised["sleep_s"] and now >= n.next_query):
                    self.start(n, GET_CONFIG)
                elif n.config_job:
                    if n.protocol_version == 2 and any(n.config_job[k] != CONFIG_DEFAULTS[k] for k in ("tx_power_dbm", "listen_ms", "max_awake_ms")):
                        continue
                    job = n.config_job
                    if job["revision"] is None:
                        job["revision"] = n.advertised["revision"] + 1
                        if job["revision"] > 0xffffffff:
                            n.config_status = "Revisión agotada";n.config_job = None
                            self.persist();self.config_view(n);continue
                        self.persist()
                    self.start(n, SET_CONFIG, revision=job["revision"], **{k: job[k] for k in CONFIG_KEYS})
                elif n.advertised["sleep_s"]:
                    self.start(n, END)
                else:
                    continue
            n.last_tx = now
            n.pending["dispatch_at"] = now
            return n.ident, n.pending["packet"]
        return None

    def sent(self, node, success=True):
        n = self.nodes[node]
        p = n.pending
        if not p:
            return
        now = self.now()
        if p["tries"]:
            n.metrics["retries"] += 1
        p["tries"] += 1
        p["sent_at"] = now
        n.metrics["tx_attempts"] += 1
        if not success:
            n.metrics["tx_errors"] += 1
        action = n.actions.get(p["frame"].op)
        if action:
            action["attempts"] = action.get("attempts", 0) + 1
            if action.get("first_sent_at") is None:
                action["first_sent_at"] = p.get("dispatch_at", now)
        valve_pulse = n.advertised["pulse_ms"] / 1000 if p["frame"].op == SET_VALVE else 0
        ack_airtime = airtime_seconds(FRAME_SIZE if n.protocol_version == 3 else 38)
        response_budget = .15 + ack_airtime + .15
        p["next"] = now + max(1.5, response_budget + .5) + valve_pulse
        # The ACK follows the completed GPIO pulse. Reserve RX through its airtime.
        self.tx_ready = now + (max(.65, valve_pulse + response_budget) if p["frame"].op == SET_VALVE else response_budget)
        if n.advertised["sleep_s"] and p["frame"].op != END:
            n.active_until = min(now + valve_pulse + n.advertised["listen_ms"] / 1000 - .2, n.hard_until)
        if not success:
            n.need_query = True
        if p["frame"].op == END:
            p["tries"] = 3  # Missing END ACK is harmless; do not transmit into its sleep.
