SorianoJuan/chacaico-automation/(commit log)

2026-10-20 Show independent valve command status on the main dashboard
2026-10-20 Record valve command queued during node 1 sleep
2026-10-20 Document CubeCell GPIO measurement points with a wiring diagram
2026-10-21 Document valve driver electrical issue and AOP605 retrofit proposal
2026-10-23 Add native valve schedules with manual season control and bounded commands
2026-10-23 Simplify valve scheduling to daily From and Until controls
2026-10-23 Clarify daily valve time labels as start and cutoff
2026-10-23 Add shared weekday selection to valve schedules
2026-10-23 Queue maximum radio power before node contact
